skybased/lbs/IMG_20171111_220439.jpg

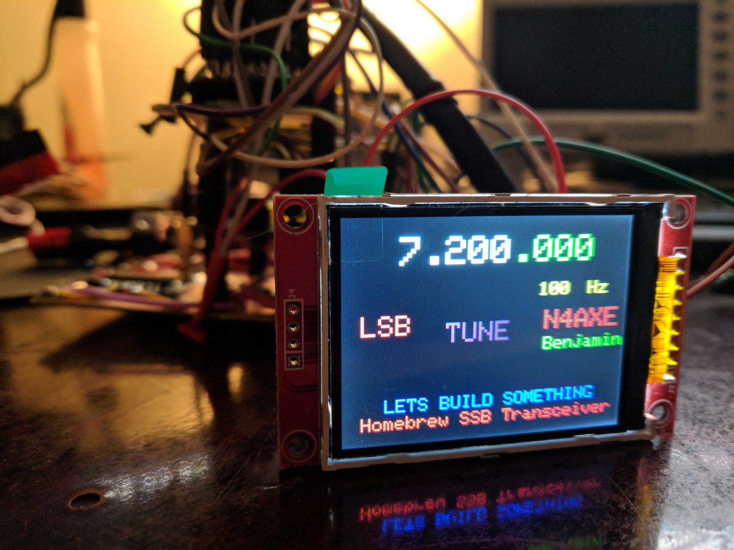
IMG_20171111_220439.jpg
