skybased/lbs/Other Information/Trifiliar.png

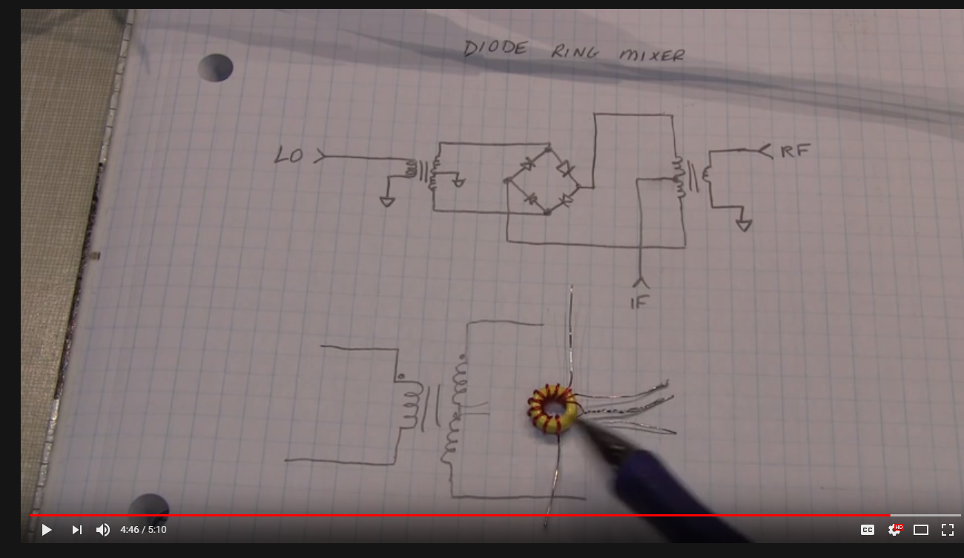
Other Information/Trifiliar.png
