skybased/lbs/README.md

# Lets-Build-Something
An arduino Uno sketch with Foutx4, I/Q and making use of 2.2"TFT Display
