skybased/lbs/KiKad Project Files/Block Diagram P1.jpg

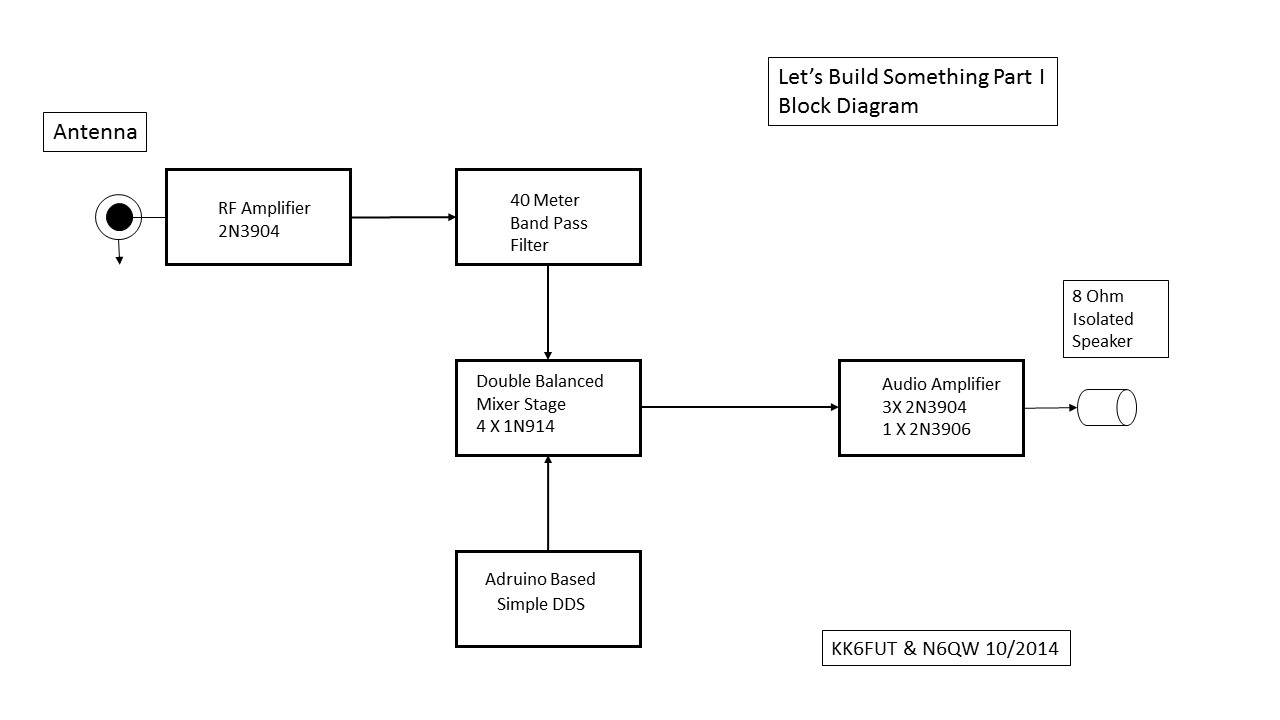
KiKad Project Files/Block Diagram P1.jpg
