skybased/lbs/KiKad Project Files/Block Diagram P2.jpg

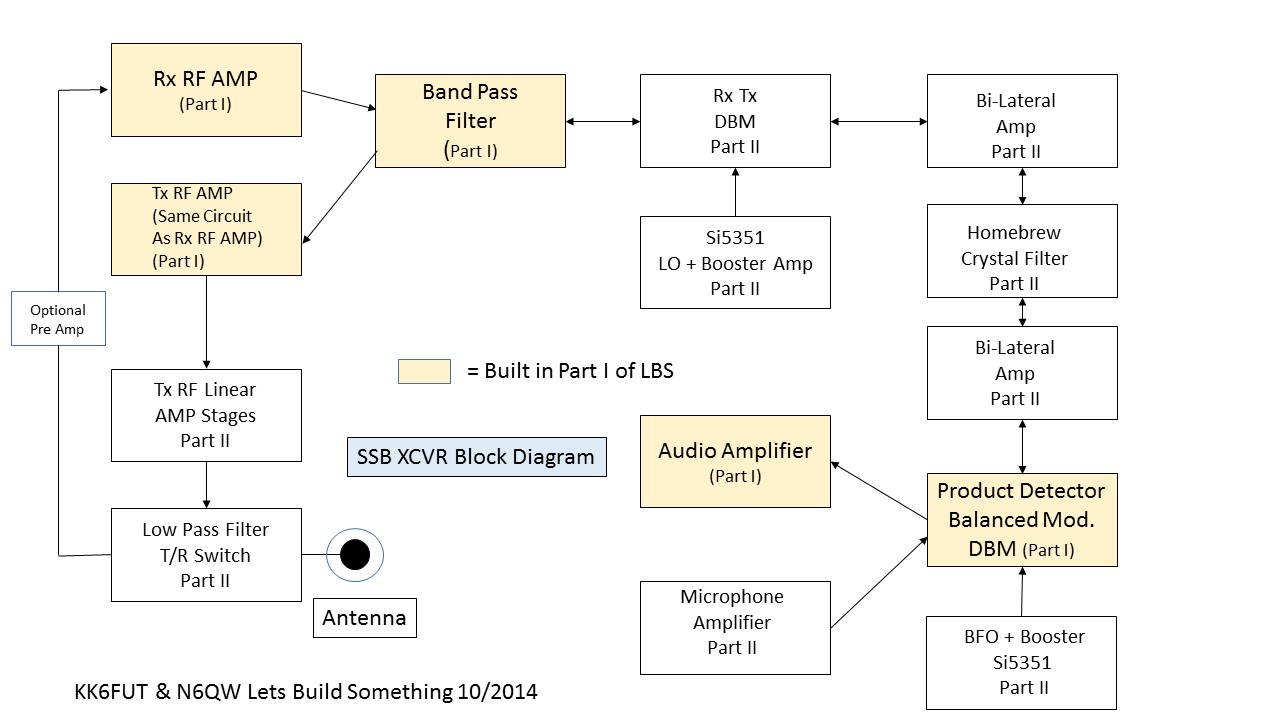
KiKad Project Files/Block Diagram P2.jpg
