skybased/lbs/Other Information/G6k-2P-T-Dc5(c).jpg

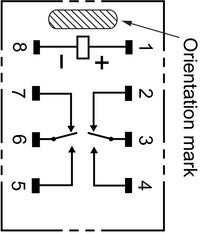
Other Information/G6k-2P-T-Dc5(c).jpg
