skybased/lbs/PDF Schematics/Audio Amplifier.pdf

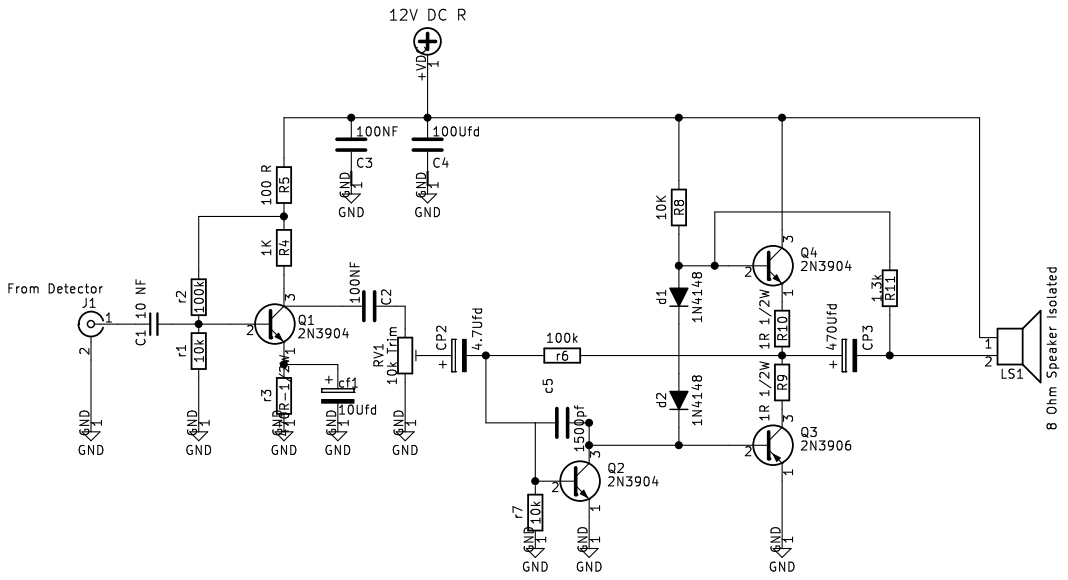
[picture p27: page 1]
