skybased/lbs/PDF Schematics/Bilateral Crystal Filter & Amp.pdf

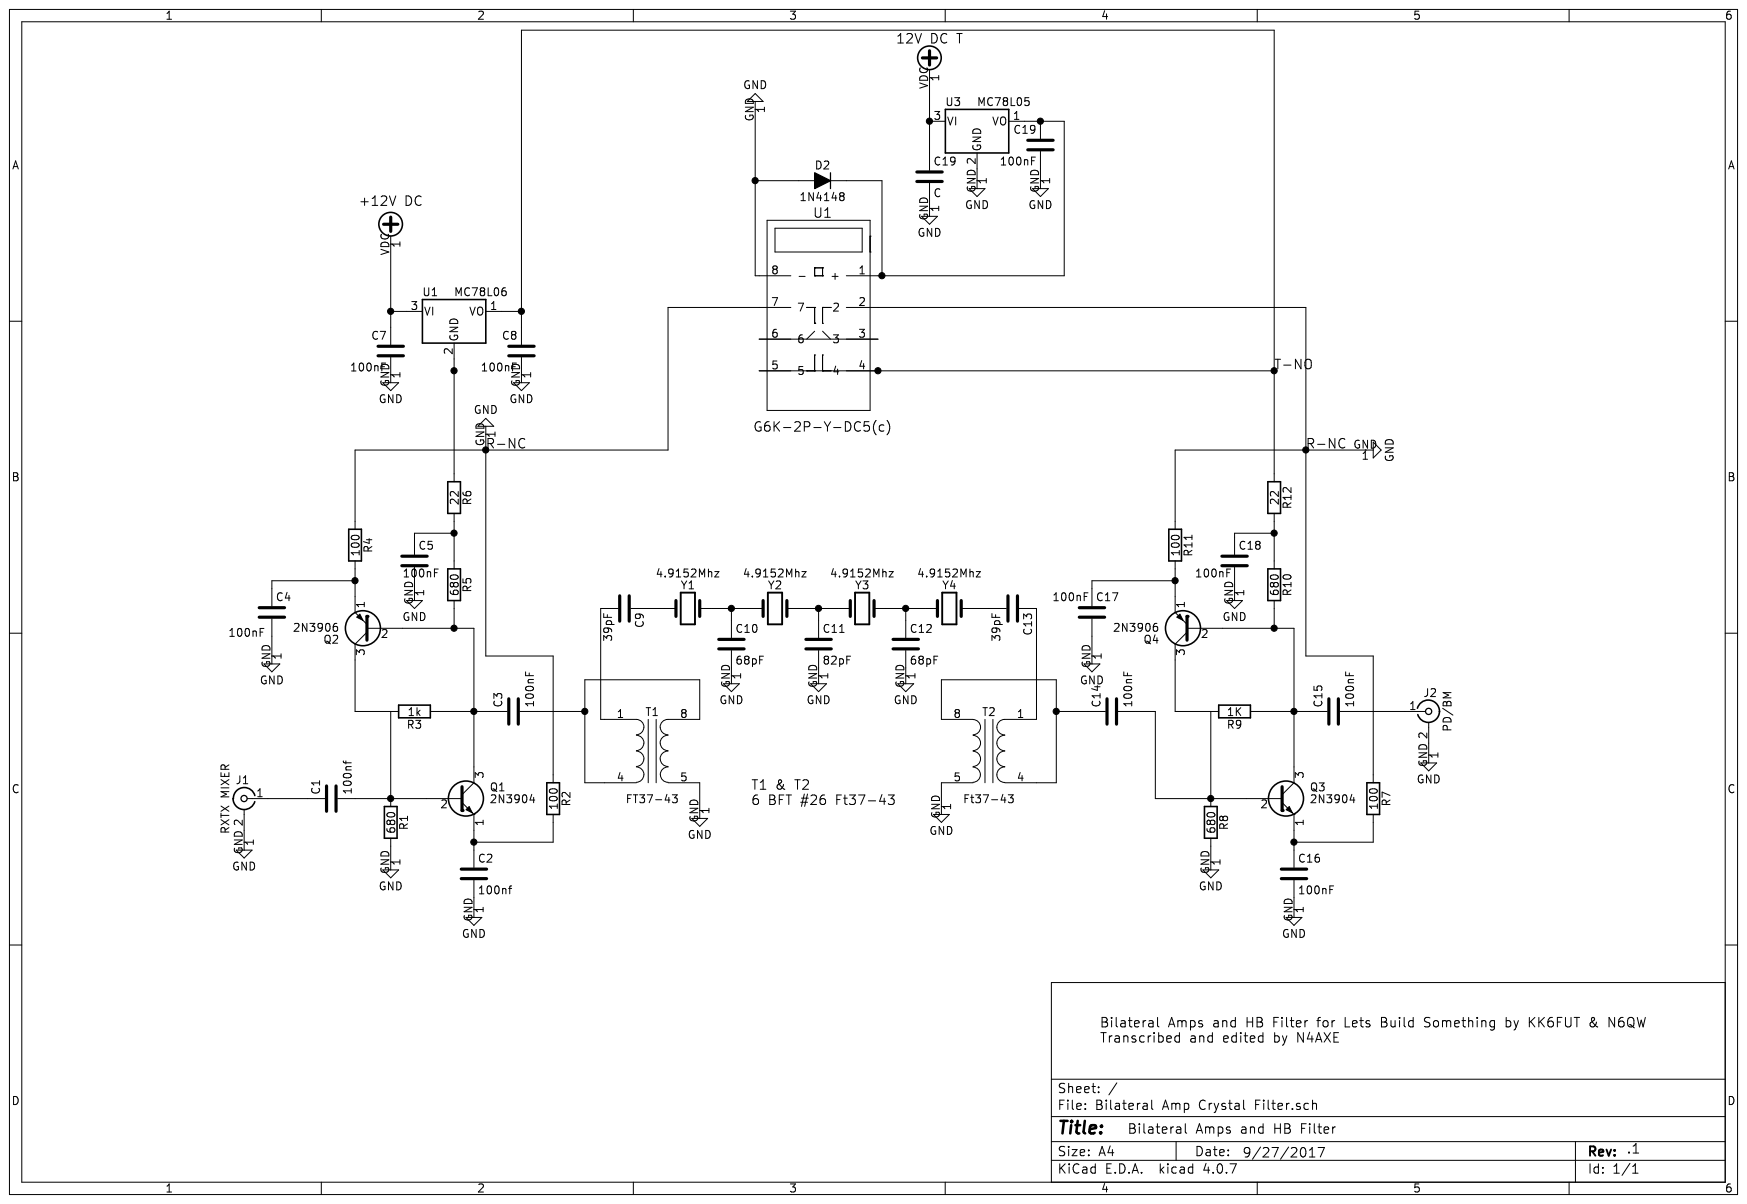
[picture p28: page 1]
