skybased/lbs/PDF Schematics/Control Board.pdf

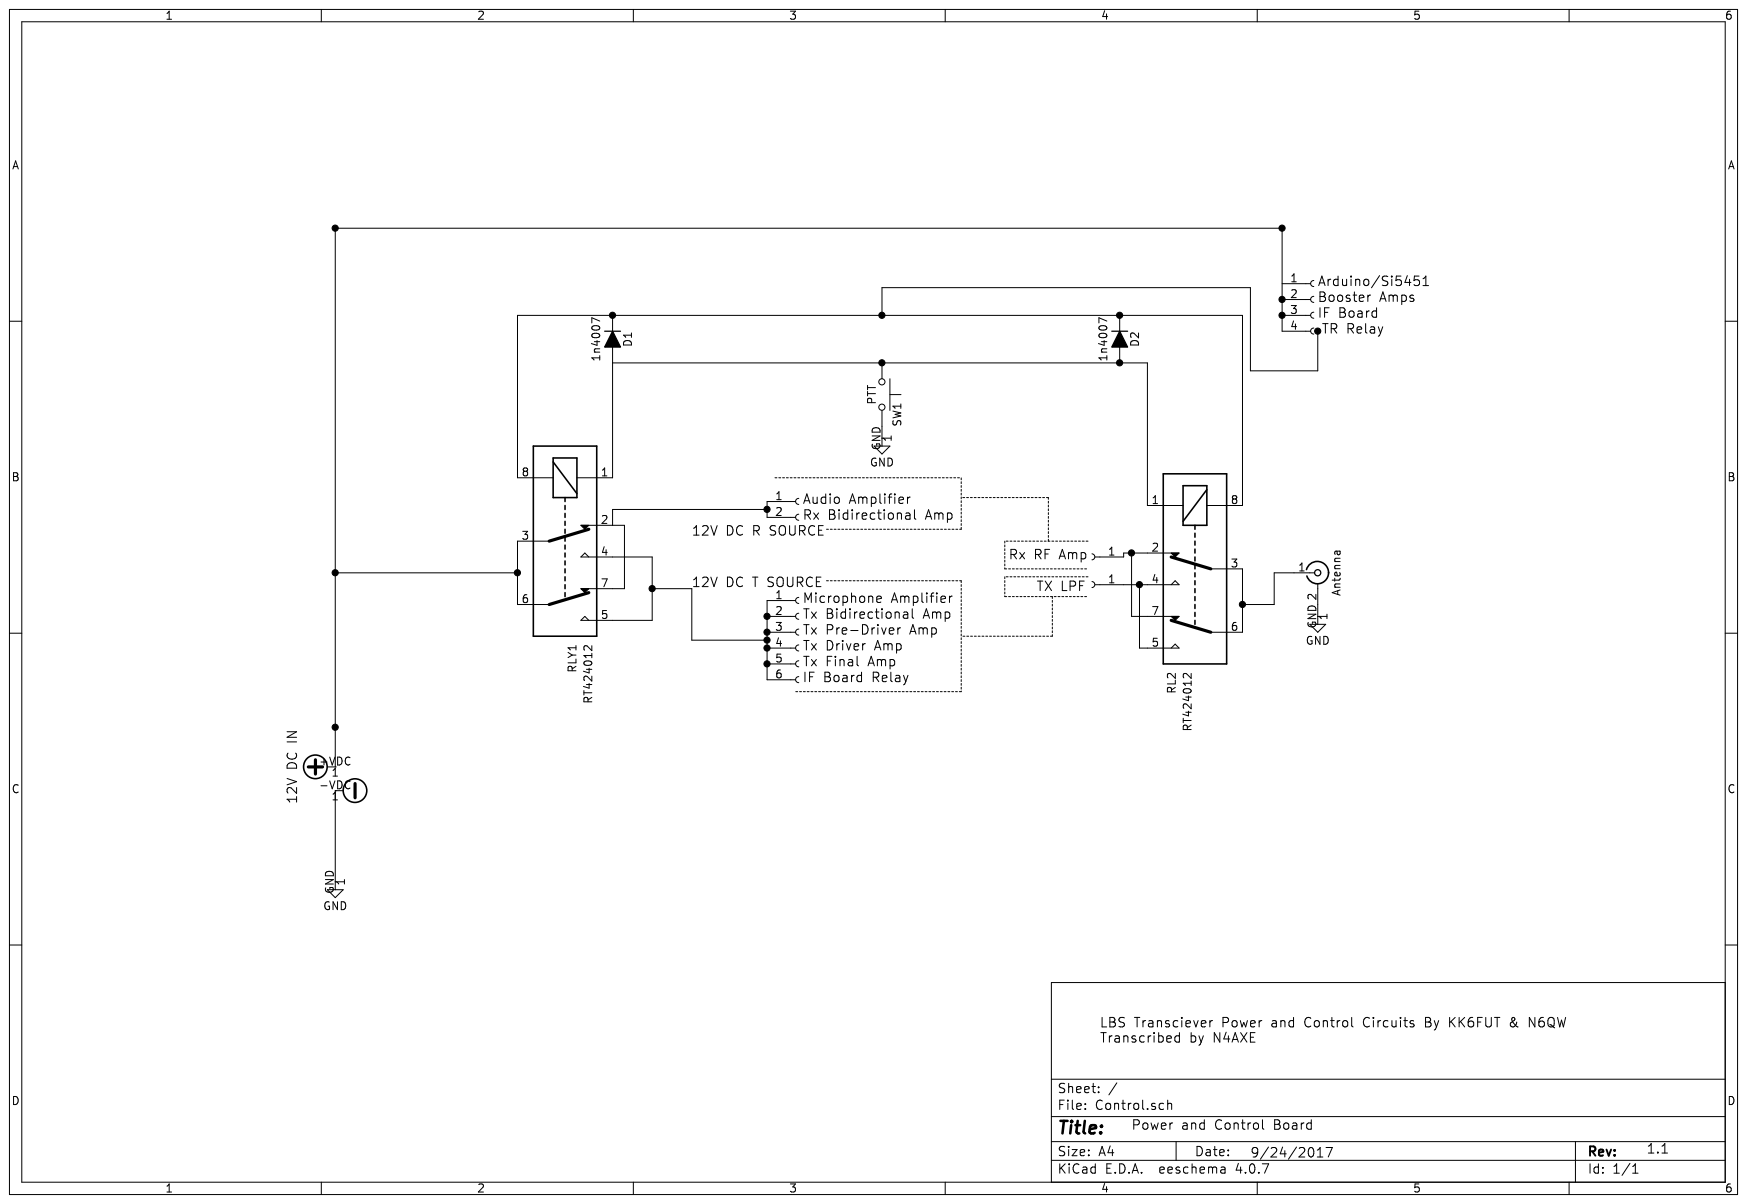
[picture p29: page 1]
