skybased/lbs/PDF Schematics/Double Balanced Mixer.pdf

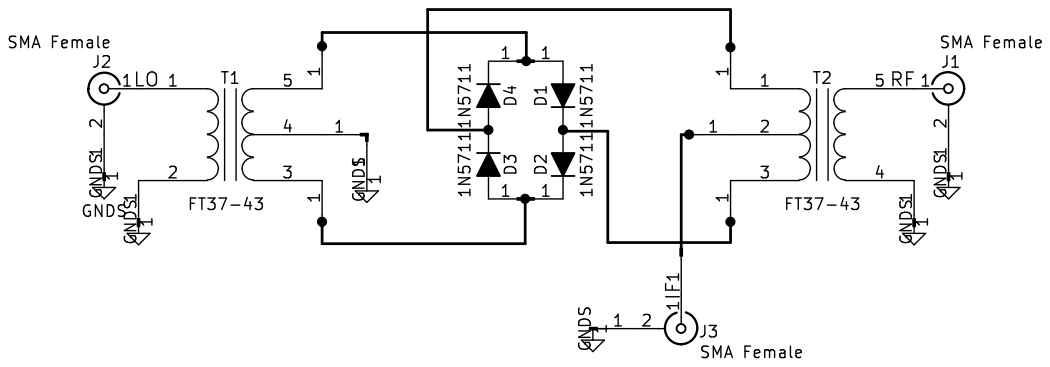
[picture p30: page 1]
