skybased/lbs/PDF Schematics/Microphone Amplifier.pdf

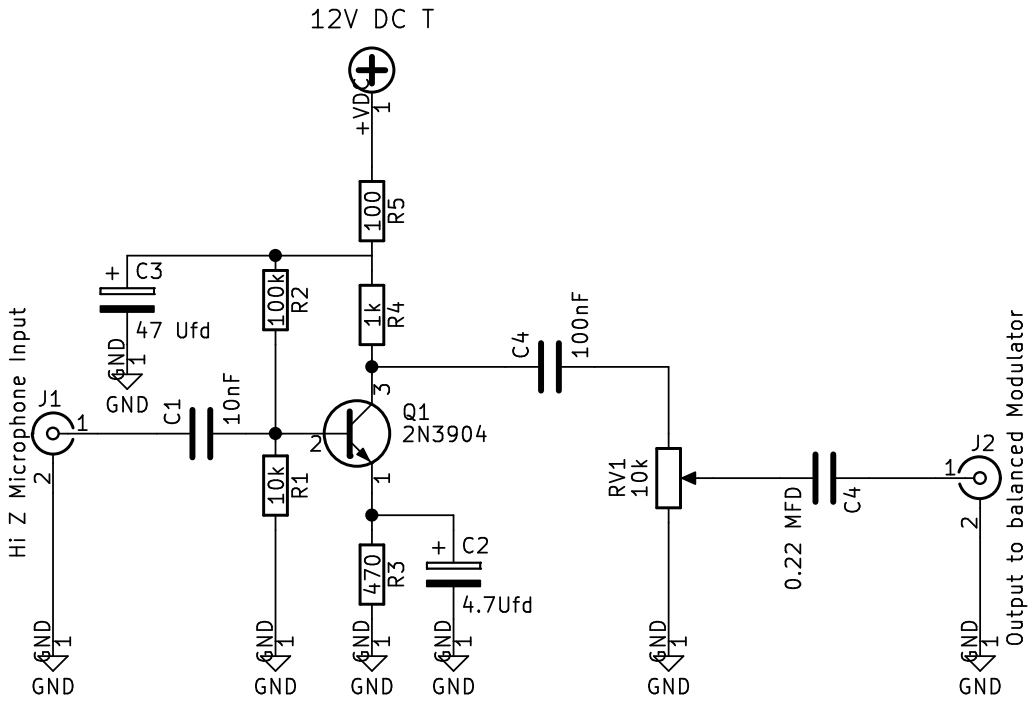
[picture p31: page 1]
