skybased/lbs/PDF Schematics/Optional RX Pre-Amp.pdf

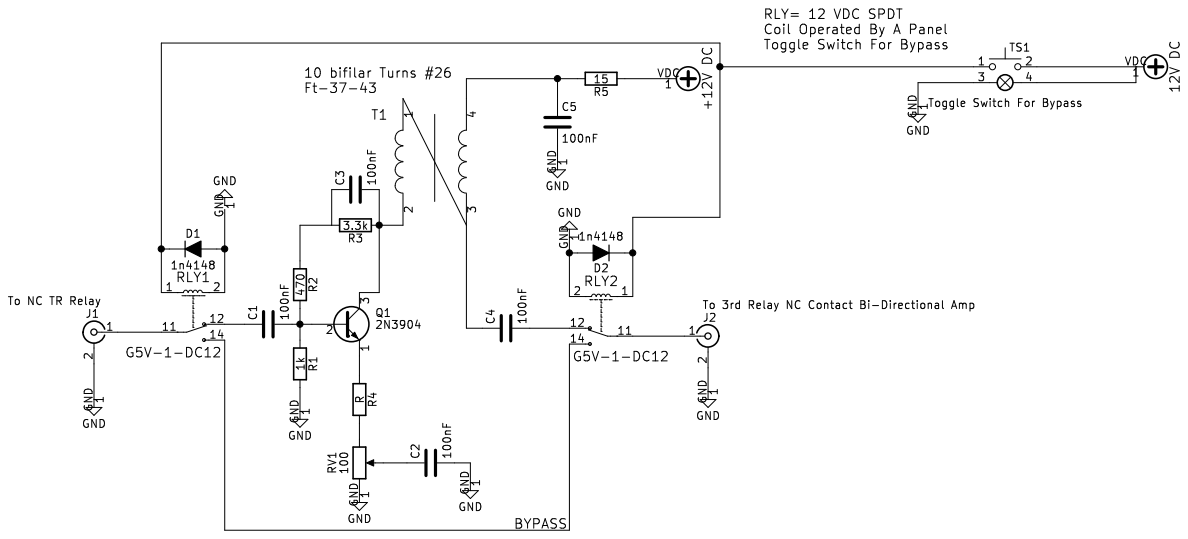
[picture p32: page 1]
