skybased/lbs/PDF Schematics/Product Detector.pdf

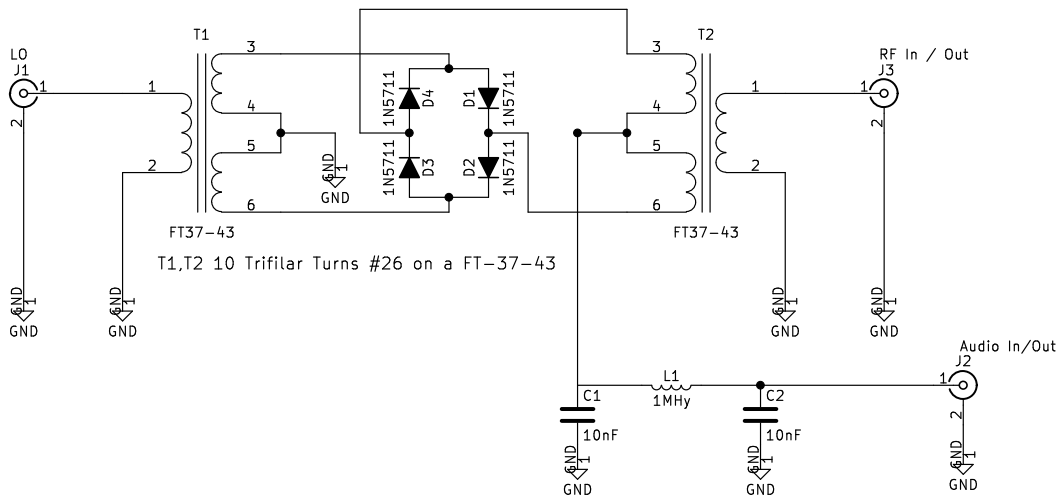
[picture p33: page 1]
