skybased/lbs/PDF Schematics/si5251 Signal Amp.pdf

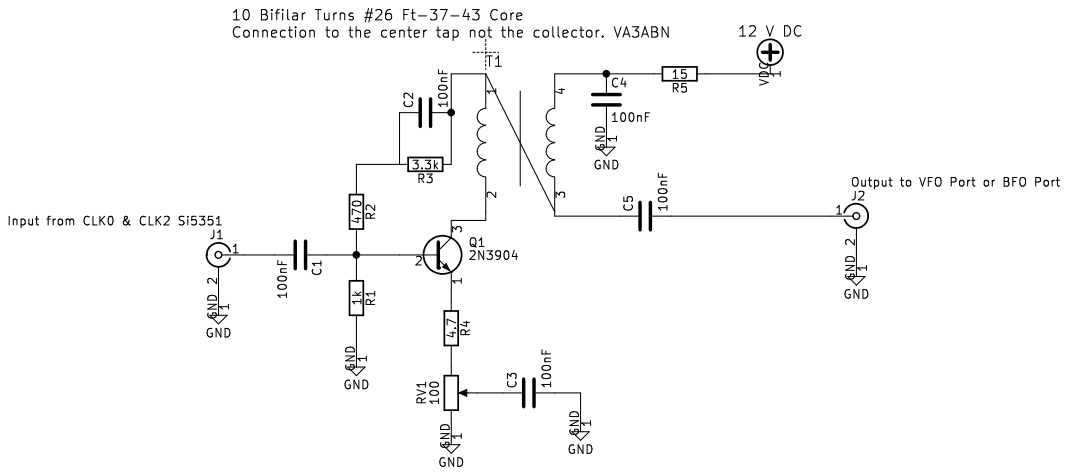
[picture p34: page 1]
