skybased/lbs/PDF Schematics/Tx Pre Driver and Driver Amplifier.pdf

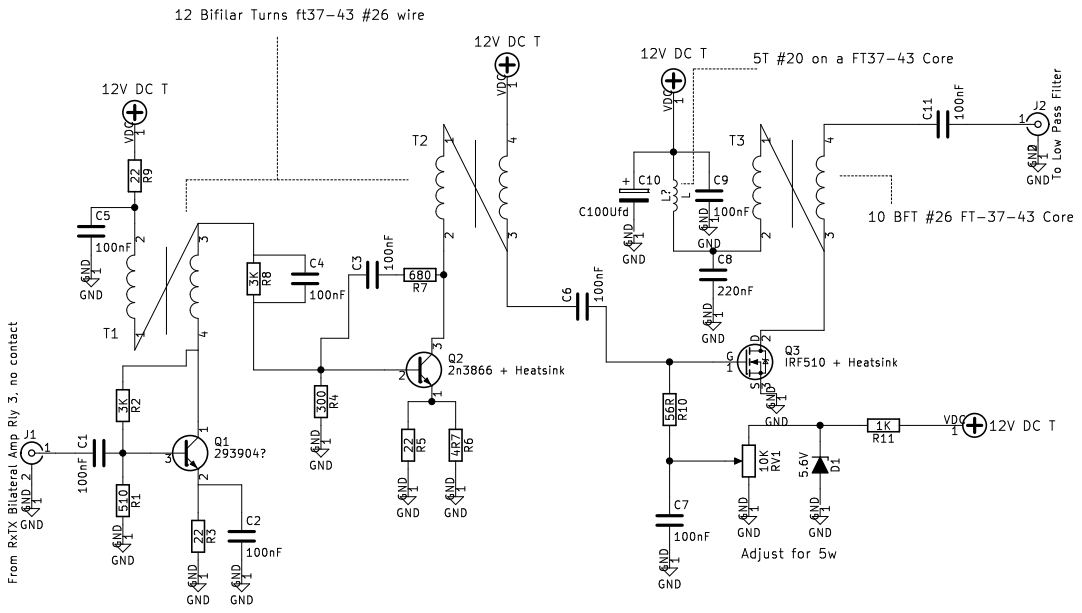
[picture p35: page 1]
