skybased/lbs/KiKad Project Files/Audio Amplifier/Audio Amplifier.pdf

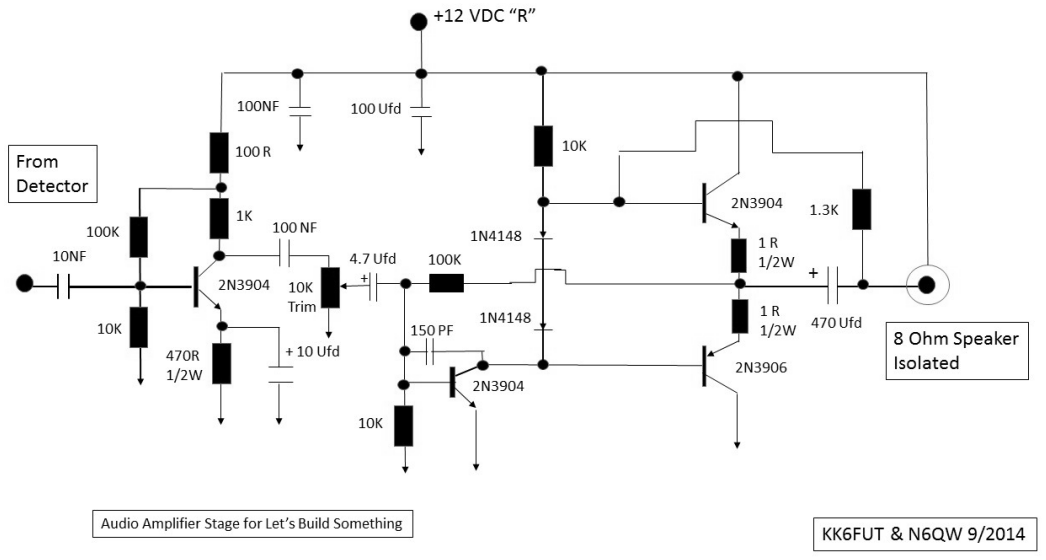
[picture p36: page 1]
