skybased/lbs/KiKad Project Files/Audio Amplifier/40m Band pass filter/40m Bandpass Filter 2/40m Bandpass Filter 2.kicad_pcb

## KiCad design KiKad Project Files/Audio Amplifier/40m Band pass filter/40m Bandpass Filter 2/40m Bandpass Filter 2.kicad_pcb (2017-11-13)

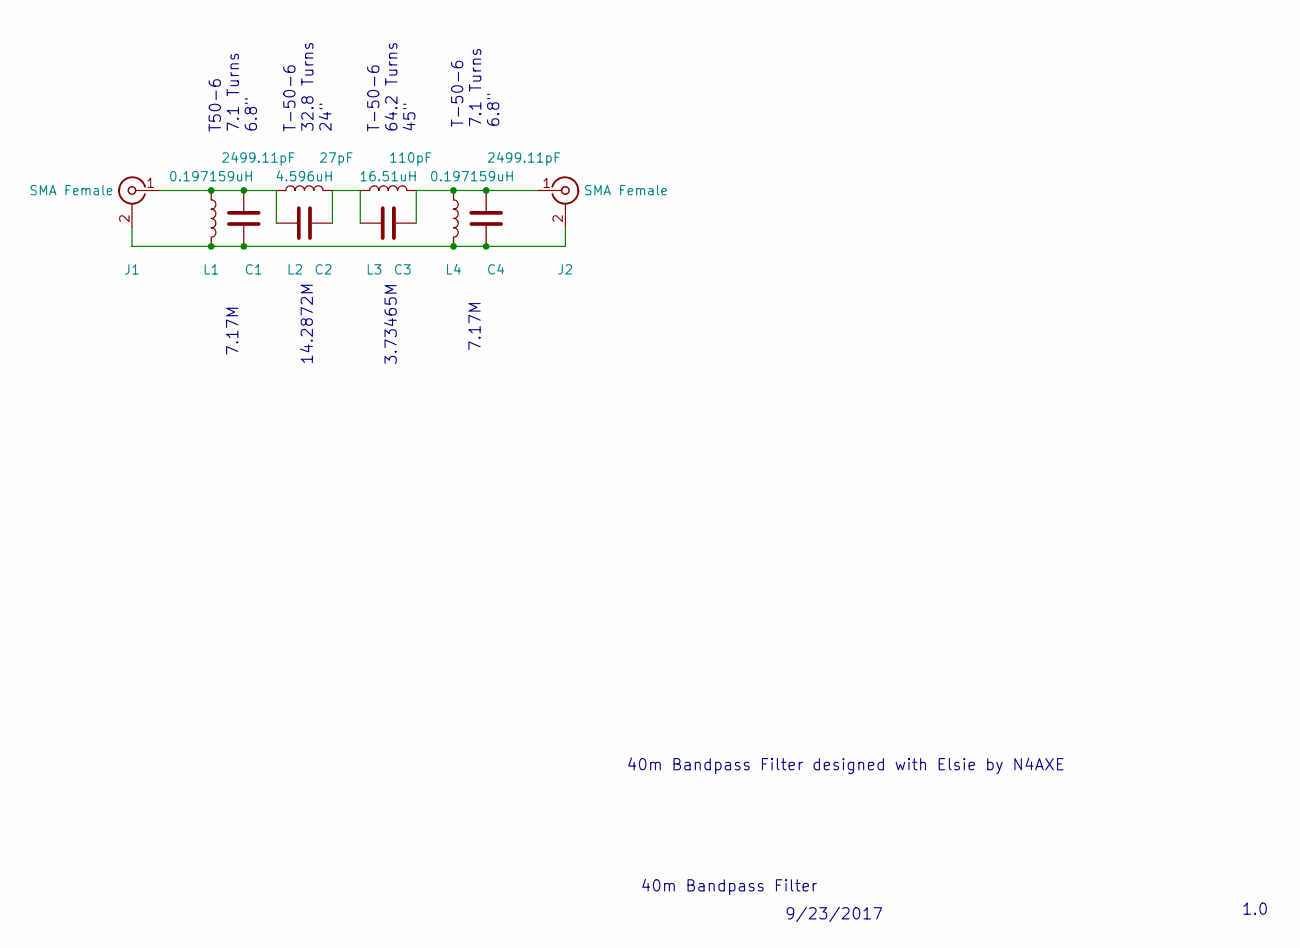
[picture p37: schematic 40m Bandpass Filter 2.sch]

Parts:
C1, C4: 2499.11pF; C_Rect_L11.5mm_W6.4mm_P10.00mm_MKT
C2: 27pF; C_Rect_L11.5mm_W6.4mm_P10.00mm_MKT
C3: 110pF; C_Rect_L11.5mm_W6.4mm_P10.00mm_MKT
J1, J2: SMA Female; SMA_THT_Jack_Straight
L1, L4: 0.197159uH; L_Toroid_Vertical_L10.0mm_W5.0mm_P5.08mm
L2: 4.596uH; L_Toroid_Vertical_L10.0mm_W5.0mm_P5.08mm
L3: 16.51uH; L_Toroid_Vertical_L10.0mm_W5.0mm_P5.08mm

Connections:
unnamed: C1.1, C2.2, J1.1 (In), L1.1, L2.1
unnamed: C1.2, C4.2, J1.2 (Ext), J2.2 (Ext), L1.2, L4.2
unnamed: C2.1, C3.2, L2.2, L3.1
unnamed: C3.1, C4.1, J2.1 (In), L3.2, L4.1

Notes on the sheet:
40m Bandpass Filter
9/23/2017
1.0
7.17M
14.2872M
3.73465M
T50-6 7.1 Turns 6.8"
T-50-6 32.8 Turns 24"
T-50-6 7.1 Turns 6.8"
T-50-6 64.2 Turns 45"
40m Bandpass Filter designed with Elsie by N4AXE

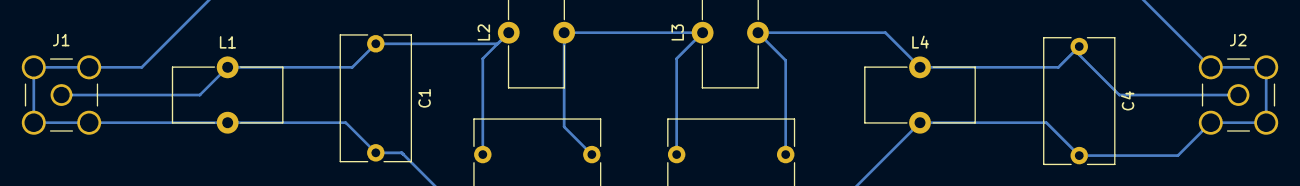
[picture p38: board 40m Bandpass Filter 2.kicad_pcb from above]

Board: 2 copper layers, 10 parts (0 on the bottom side), 4 nets.
