skybased/lbs/(commit log)

2017-11-13 Arduino Sketch For Lets Build Something Radio
    Five band ready
    si5351 x4 out for use with /4 flipflop 6-12db gain in dynamic range
    2.2" TFT Display Required CD 4050 Level Shifter
    USB/LSB
    Tune Function with 988hz tone with proper LO output
    Added further comments to variables
    Added a better color table
    Some Code Cleaning
    [LBSSketch.ino]
2017-11-13 Added PDF and Kikad & Pete's Original Schematics
    Missing a few need to clean up a few things, will add them asap
    [40m Band pass filter.kicad_pcb, 40m Band pass filter.sch, 40m Bandpass Filter 2.kicad_pcb, 40m Bandpass Filter 2.sch, Audio Amplifier.kicad_pcb, Audio Amplifier.sch, Bilateral Amp Crystal Filter.kicad_pcb, Bilateral Amp Crystal Filter.sch]
